nicolube/Co2Det/Materialanforderung_31032021_Lernprojekt.xls

 |  | Anforderungsdatum |  | 2021-03-31
 |  | Abteilung |  | Berufsschule
 |  | Warenempfänger |  | Leila Mekacher
 |  | - Telefon |  | 1551
 |  | - Haus/Niveau/Raum |  | TC_OG20
 |  | Kostenstelle |  | 2065 |  | gesehen (Datum)
 |  | KST-Verantwortlicher |  | Bernd Marek |  | 2021-03-31
 |  | Submissionsnummer |  | 2065Ma0006
Position | Artikelbezeichnung/Artikelnummer (Artikelnummer bei Lehr- und Lernmittellager Muß-Eingabe) | Menge | Mengen- Einheit |  | Lieferdatum | Bemerkung (Neu-/Ersatzbeschaffung, Begründung bei GWGs, Verwendung für..., Preis soweit bekannt)
1 | CO2 MH-Z19C-PH Infrarot CO2-Sensor, MH-Z19C, Pinleiste RM 2,54 | 40 | ST |  |  | reichelt
2 | DEBO LCD 16X2 BL Entwicklerboards - Display, 16 x 2 Zeichen, blau | 40 | ST |  |  | reichelt
3 | ARD NANO 33IOT HArduino Nano 33 IOT, SAMD21G18A, mit Header | 40 | ST |  |  | reichelt
4 | AWG 28-09G 30M Flachbandkabel AWG28, 9-pol., grau, 30m-Ring | 1 | ST |  |  | reichelt
5 | SUMMER TDB 05 Elektromagnetischer Summer | 45 | ST |  |  | reichelt
6 | MPR 680 Widerstand, Metallschicht, 680 Ohm, 0207, 0,6, 0,1% | 50 | ST |  |  | reichelt
7 | BC 547A CDIL Bipolartransistor, NPN, 45V, 0,1A, 0,5W, TO-92 | 50 | ST |  |  | reichelt
8 | DI 5MM Distanzhülsen, Metall, 6-Kant, M3, 5mm | 170 | ST |  |  | reichelt
9 | KNOPF 17-6 AL Potentiometerknopf für Achse Ø 6 mm, silber | 40 | ST |  |  | reichelt
10 | PFL 10 Pfostenbuchse, 10-polig, mit Zugentlastung | 50 | ST |  |  | reichelt
11 | DA 5MM Distanzhülsen, Metall, 6-Kant, M3, 5mm | 170 | ST |  |  | reichelt
12 | SSK M3X6-200 Flach-Senkkopfschrauben, Schlitz, M3, 6 mm | 1 | P |  |  | reichelt
13 | BL 1X05G7 2,54 Buchsenleiste - 5-pol, gerade, RM 2,54, H: 7,0 mm | 45 | ST |  |  | reichelt
14 | BL 1X36G7 2,54 Buchsenleiste - 36-pol, gerade, RM 2,54, H: 7,0 mm | 80 | ST |  |  | reichelt
15 | P4-MUTTER Kontermutter für Potentiometerknöpfe, schwarz | 50 | ST |  |  | reichelt
16 | Ultimaker 1615 Filament PLA 2.85 mm 750g Orange 1 St. | 4 | ST |  |  | conrad
17 | Iduino Drehgeber 1 St. SE055 | 45 | ST |  |  | conrad
18 | Dehner Elektronik SYS 1638-0605-W2Emicro USB Steckernetzteil, Festspannung 5V/DC 1.2 A 6 W Stabilisiert | 42 | ST |  |  | conrad
19 | W & P Products 137-10-2-00-2 StiftleisteRastermaß: 2.54 mm Polzahl Gesamt: 10Anzahl Reihen: 2 1 St. | 25 | ST |  |  | conrad
20 | Fischer 657353 Senkkopfschrauben 3 mm16 mm Sechsrund galvanisch verzinkt 200St. | 1 | P |  |  | conrad
21 | TOOLCRAFT DIN7981 C-H 2,9c4,5Linsenblechschrauben 2.9 mm 4.5 mmKreuzschlitz Phillips DIN 7981 Stahl verzinkt1 St. | 170 | ST |  |  | conrad
