nicolube/Co2Det/Gehäuse/Deckel.stl

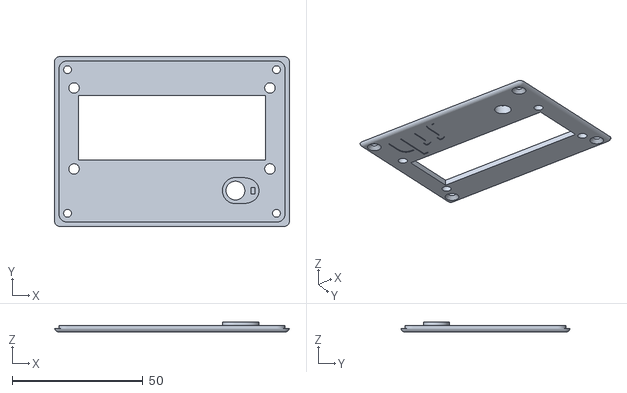
[picture p1: CAD file, 2021-04-01]
Gehäuse/Deckel.stl
90.0 x 65.0 x 4.00
