nicolube/Co2Det/Gehäuse/Logo.stl

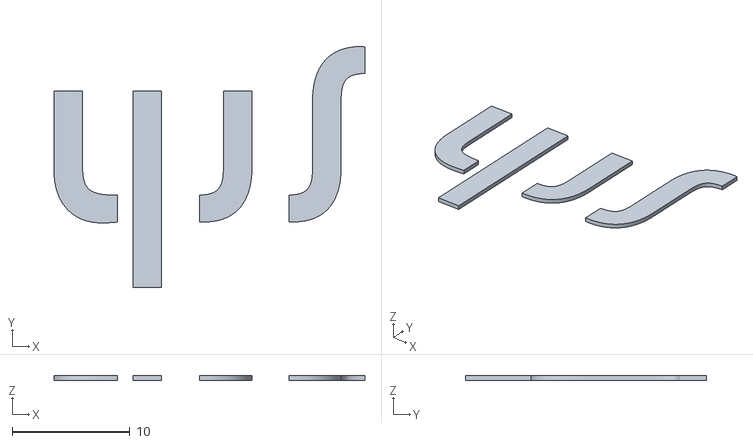
[picture p2: CAD file, 2021-04-01]
Gehäuse/Logo.stl
26.4 x 20.5 x 0.4
