nicolube/Co2Det/Gehäuse/Box.stl

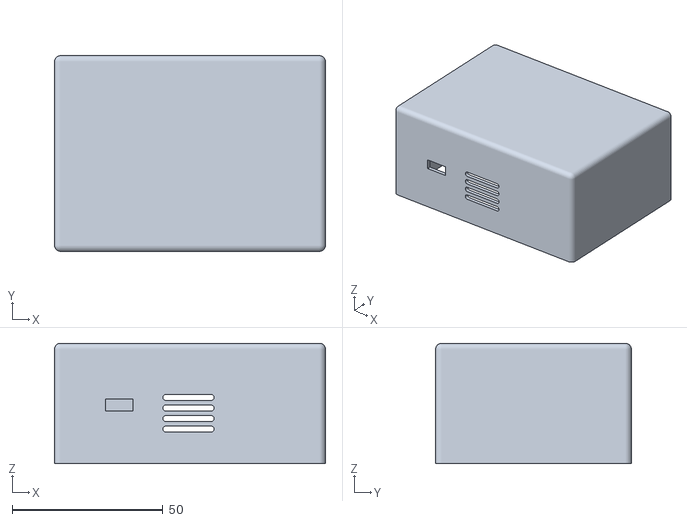
[picture p3: CAD file, 2021-04-01]
Gehäuse/Box.stl
90.0 x 65.0 x 40.0
