nicolube/Co2Det/Eagle/Co2Det.brd

## EAGLE design Eagle/Co2Det.brd (2021-04-01)

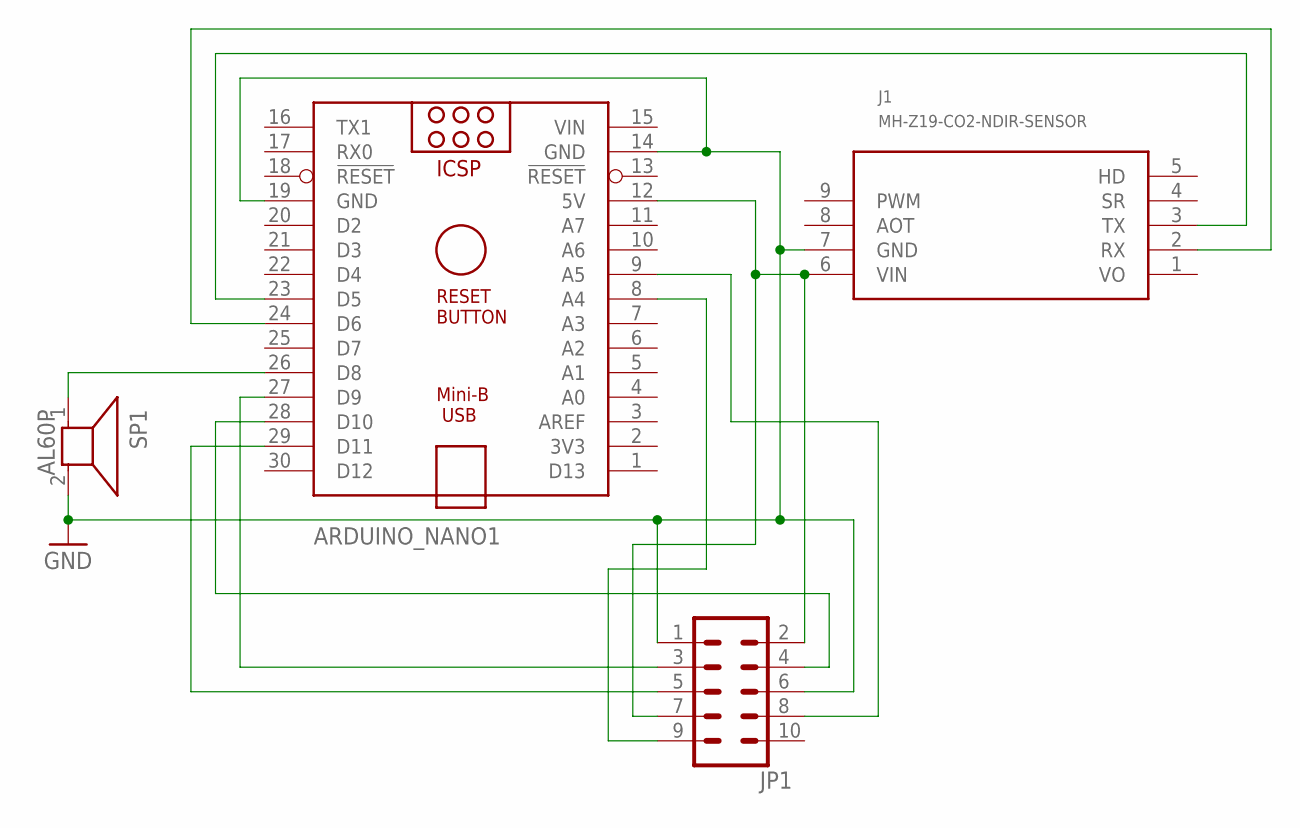
[picture p4: schematic Co2Det.sch]

Parts:
ARDUINO_NANO1: ARDUINO_NANO
J1: MH-Z19-CO2-NDIR-SENSOR; MH-Z19
JP1: ML10L
SP1: AL60P

Connections:
GND: ARDUINO_NANO1.14 (GND), ARDUINO_NANO1.19 (GND), J1.7 (GND), JP1.1, JP1.6, SP1.2
unnamed: ARDUINO_NANO1.12 (5V), J1.6 (VIN), JP1.2, JP1.7
unnamed: ARDUINO_NANO1.27 (D9), JP1.3
unnamed: ARDUINO_NANO1.28 (D10), JP1.4
unnamed: ARDUINO_NANO1.29 (D11), JP1.5
unnamed: ARDUINO_NANO1.23 (D5), J1.3 (TX)
unnamed: ARDUINO_NANO1.24 (D6), J1.2 (RX)
unnamed: ARDUINO_NANO1.8 (A4), JP1.9
unnamed: ARDUINO_NANO1.9 (A5), JP1.8
unnamed: ARDUINO_NANO1.26 (D8), SP1.1
VIN: ARDUINO_NANO1.15 (VIN)
VO: J1.1 (VO)

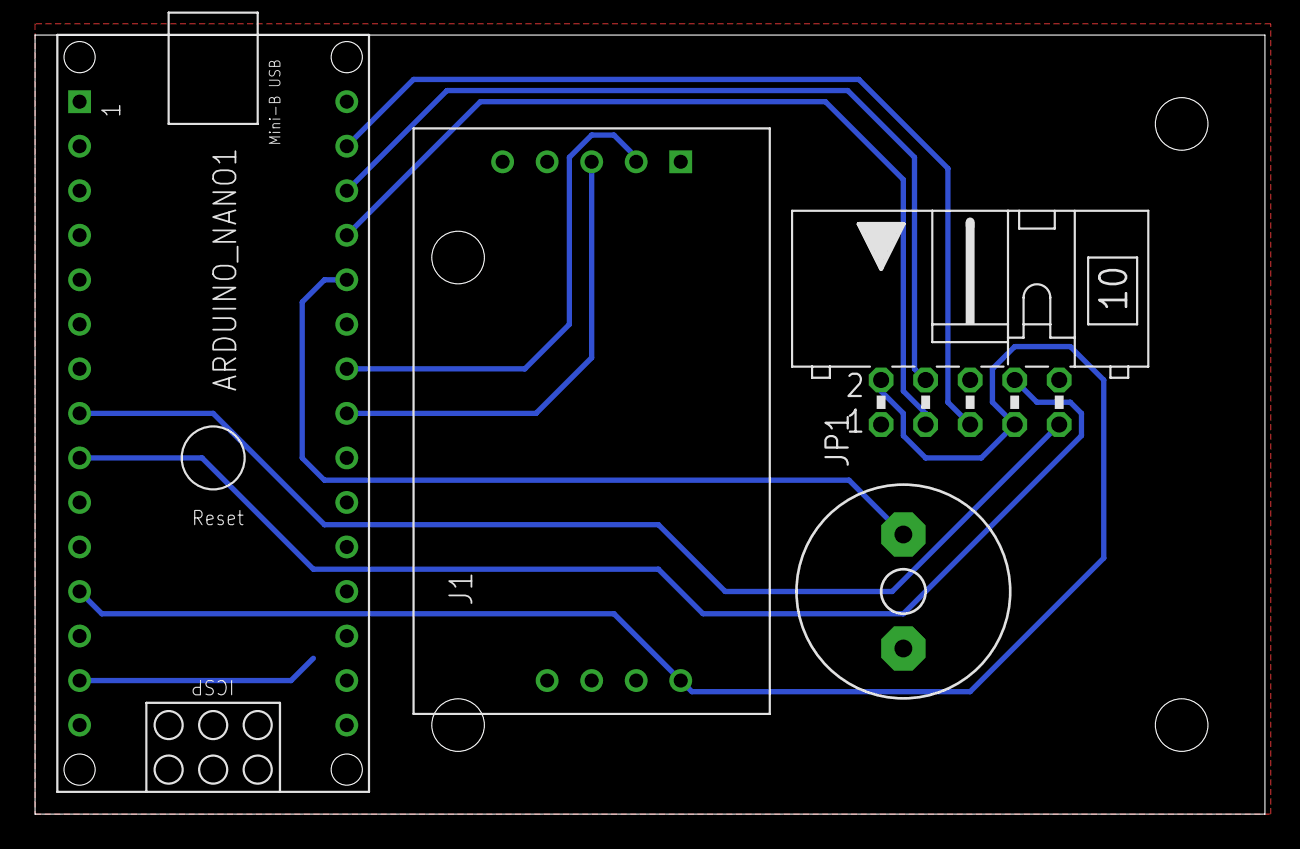
[picture p5: board Co2Det.brd from above]

Board: 2 copper layers, 70.2 x 44.4 mm, 4 parts (0 on the bottom side), 10 nets.
