nicolube/Co2Det/Co2Det/src/button.h

typedef void (*Trigger)();

class Button{

    public:
    Button(int input) : input(input){};
    void tick();
    void init(Trigger trigger);

    private:
    Trigger trigger;
    int input;
    unsigned long lMillis;
    bool isTriggered;
};
